alterlleo/kiba-board/kiba.kicad_pcb

## KiCad design kiba.kicad_pcb (2025-09-12)

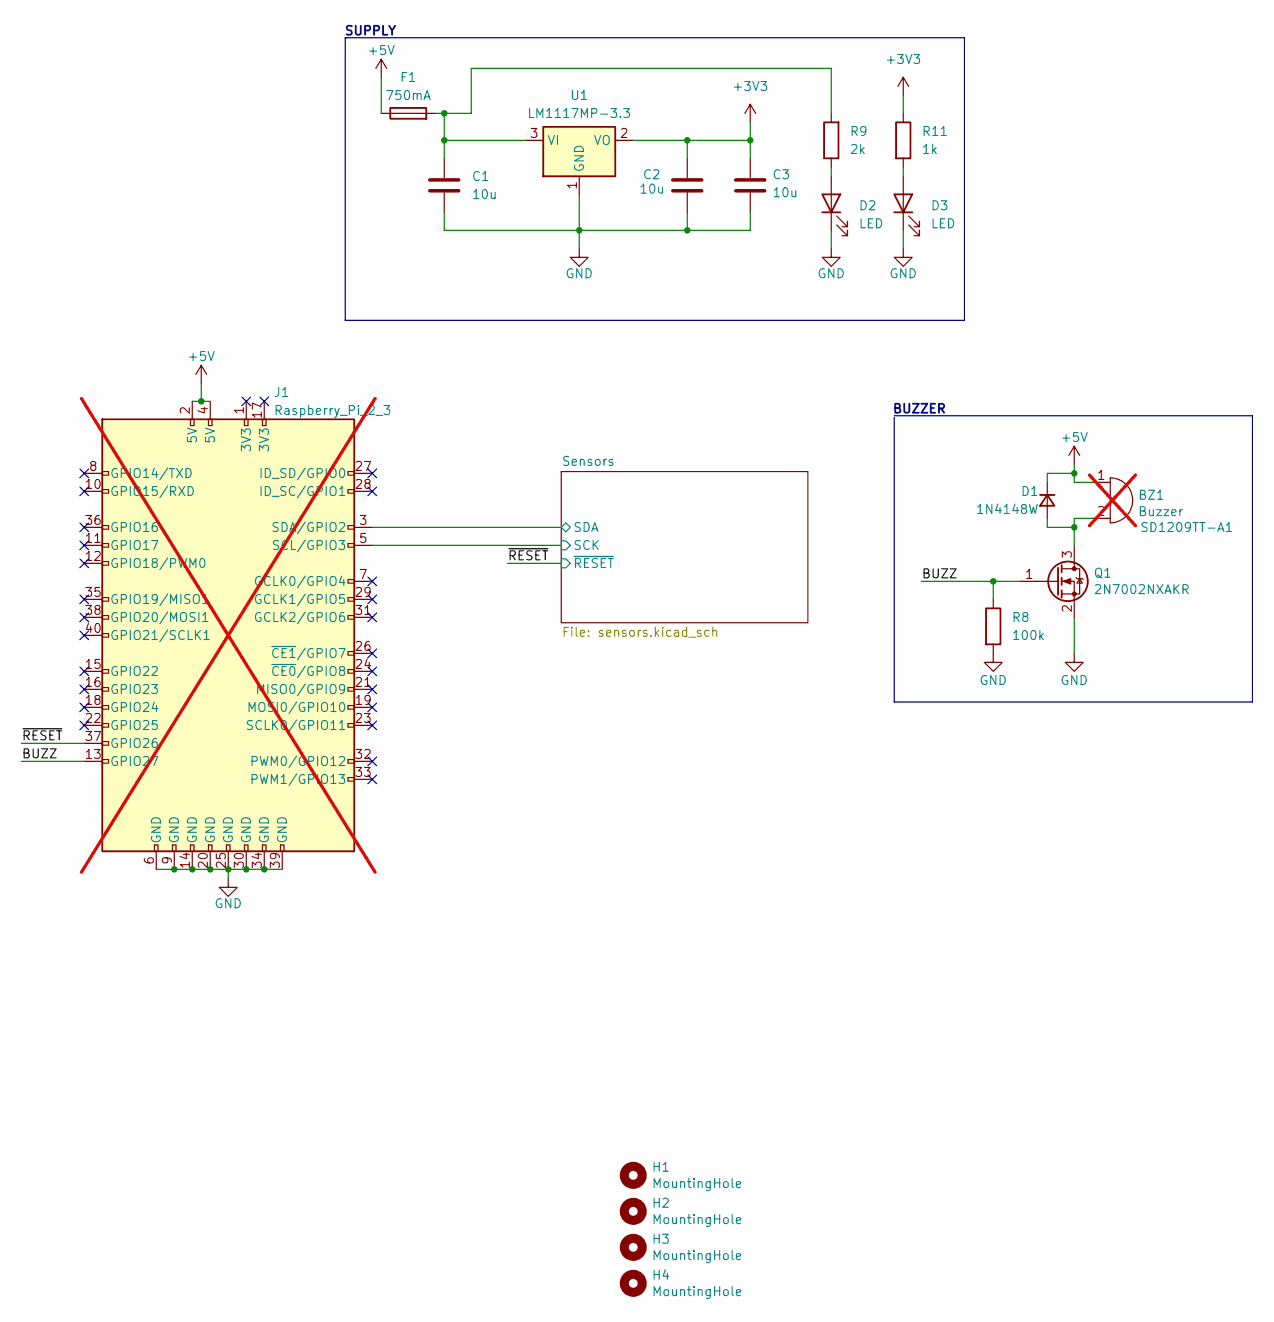
[picture p1: schematic kiba.kicad_sch]

Parts:
BZ1: Buzzer; Buzzer_TDK_PS1240P02BT_D12.2mm_H6.5mm; MPN SD1209TT-A1; LCSC C91083; not fitted
C1, C2, C3: 10u; C_0603_1608Metric
D1: 1N4148W; D_SOD-323_HandSoldering; MPN 1N4148W; LCSC C2099
D2: LED; D_0603_1608Metric; MPN TLMS1000-GS15; LCSC C2288
D3: LED; D_0603_1608Metric; MPN TLMS1000-GS15; LCSC C12624
F1: 750mA; Fuse_0603_1608Metric; LCSC C206991
H1, H2, H3, H4: MountingHole; MountingHole_3.2mm_M3_ISO14580
J1: Raspberry_Pi_2_3; raspberrypi; MPN 2.54-2*20; LCSC C2977589; not fitted
Q1: 2N7002NXAKR; SOT-23; MPN 2N7002NXAKR; LCSC C551416
R8: 100k; R_0603_1608Metric
R9: 2k; R_0603_1608Metric
R11: 1k; R_0603_1608Metric
U1: LM1117MP-3.3; SOT-223-3_TabPin2; MPN LM1117MP-3.3/TR; LCSC C498153

Connections:
+3V3: C2.1, C3.1, R11.1, U1.2 (VO); also elsewhere on the board
+5V: BZ1.1 (-), D1.1 (K), F1.1, J1.2 (5V), J1.4 (5V)
/BUZZ: J1.13 (GPIO27), Q1.1 (G), R8.1
/Sensors/SCK: J1.5 (SCL/GPIO3); also elsewhere on the board
/Sensors/SDA: J1.3 (SDA/GPIO2); also elsewhere on the board
/~RESET: J1.37 (GPIO26); also elsewhere on the board
GND: C1.2, C2.2, C3.2, D2.1 (K), D3.1 (K), J1.6 (GND), J1.9 (GND), J1.14 (GND), J1.20 (GND), J1.25 (GND), J1.30 (GND), J1.34 (GND), J1.39 (GND), Q1.2 (S), R8.2, U1.1 (GND); also elsewhere on the board
unnamed: BZ1.2 (+), D1.2 (A), Q1.3 (D)
unnamed: D2.2 (A), R9.1
unnamed: D3.2 (A), R11.2
unnamed: C1.1, F1.2, R9.2, U1.3 (VI)

Notes on the sheet:
SUPPLY
BUZZER

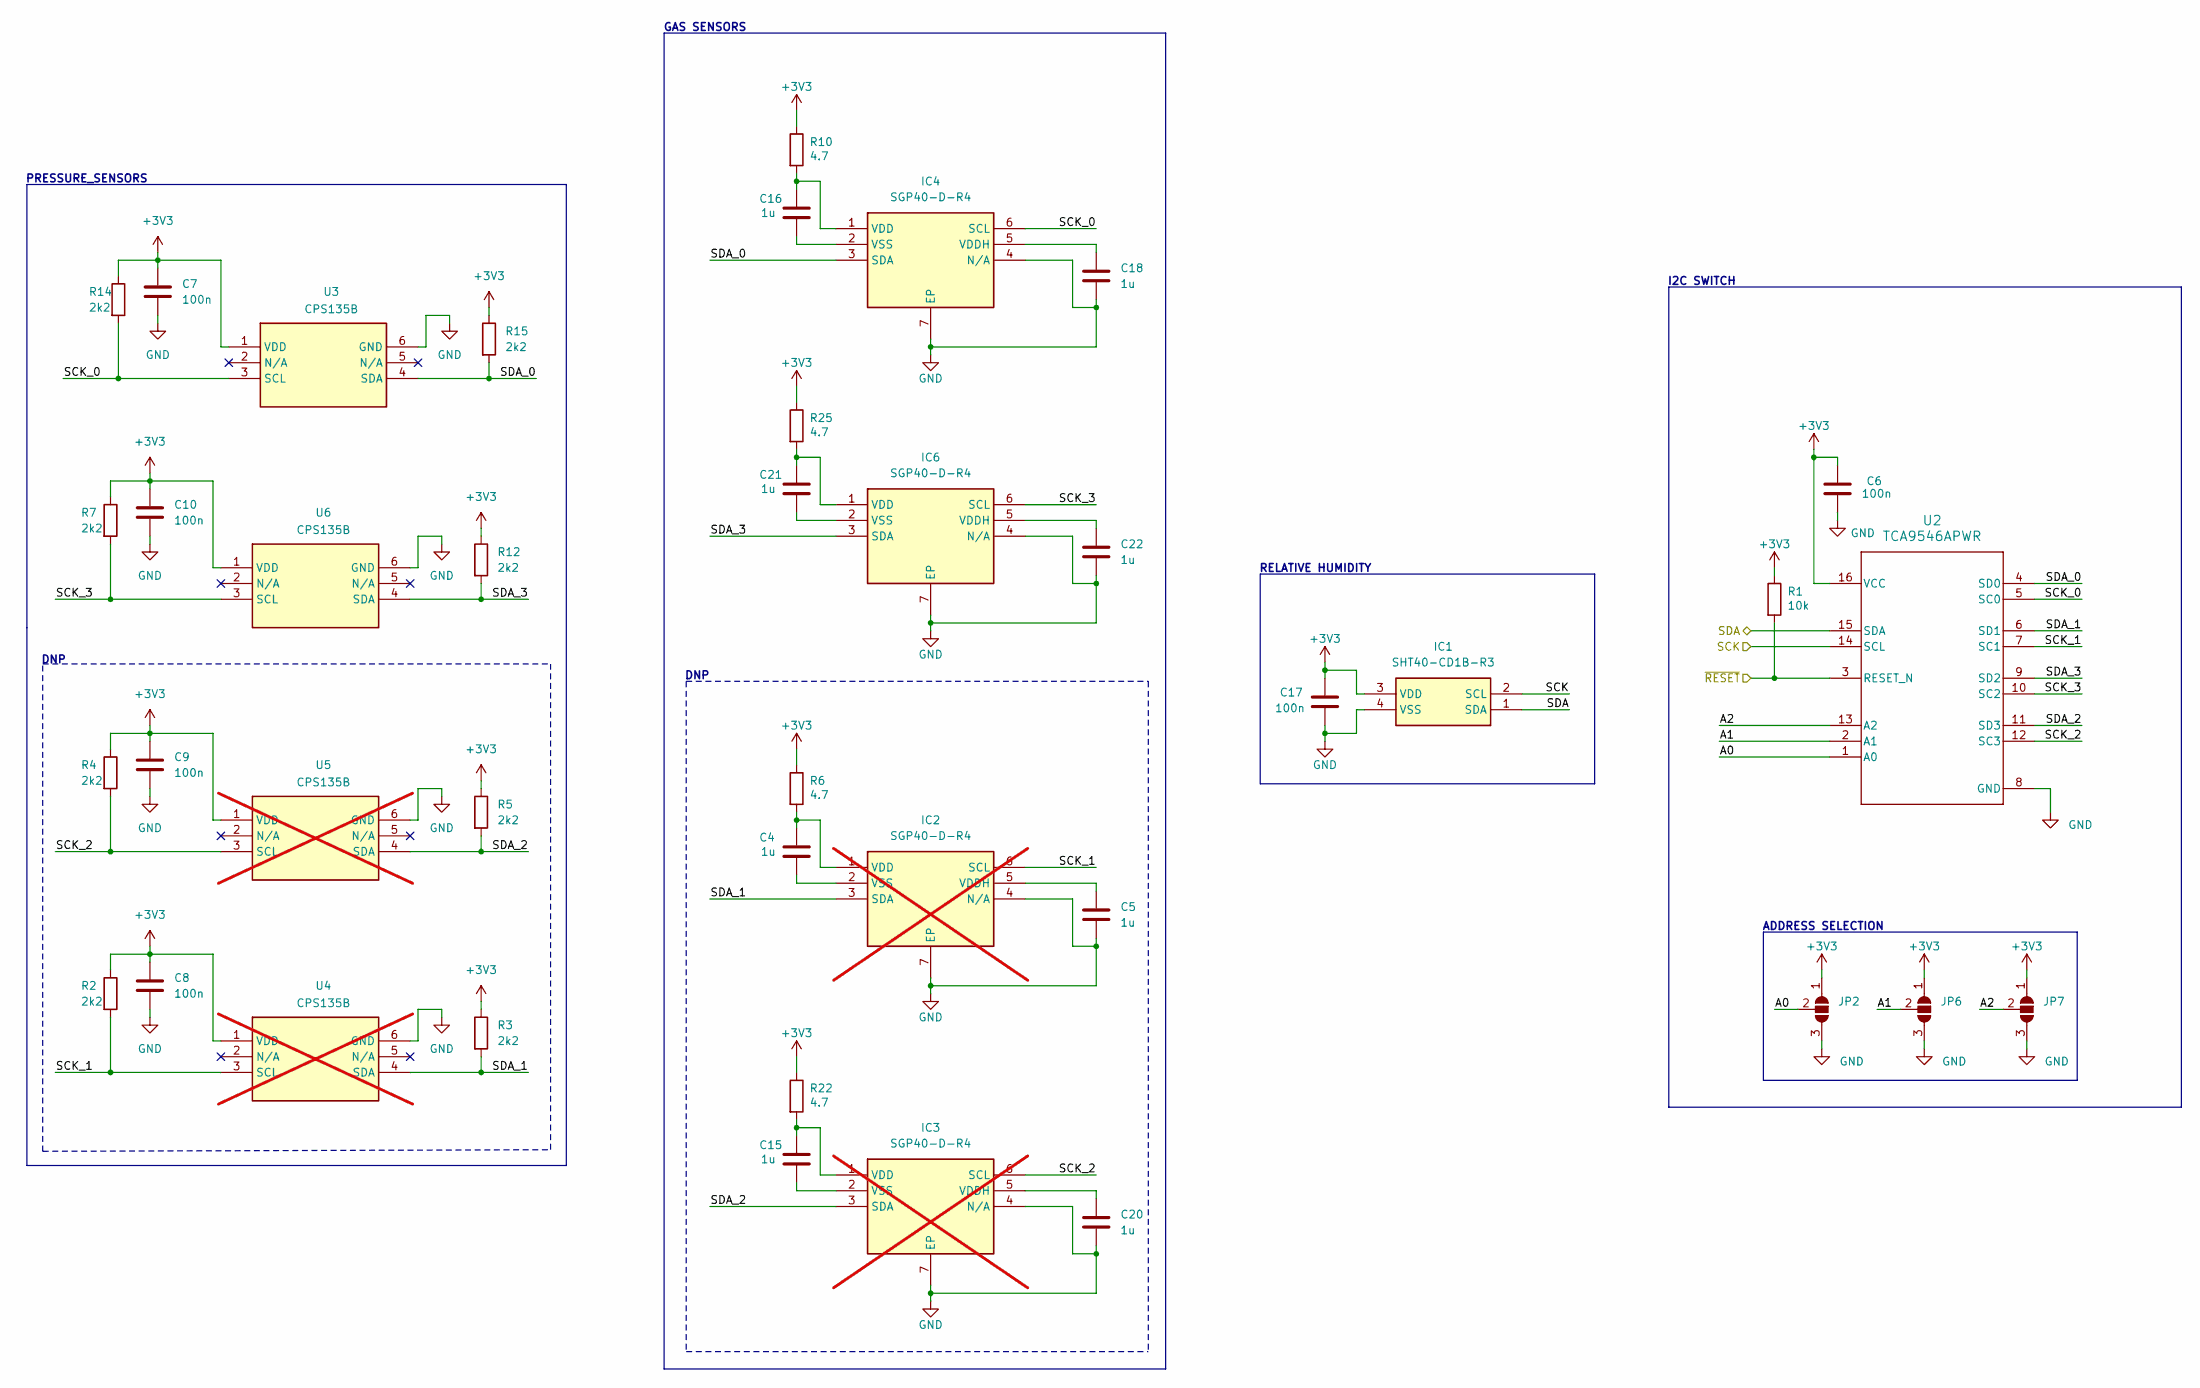
[picture p2: schematic sensors.kicad_sch]

Parts:
C4, C5, C15, C16, C18, C20, C21, C22: 1u; C_0603_1608Metric
C6, C7, C8, C9, C10, C17: 100n; C_0603_1608Metric
IC1: SHT40-CD1B-R3; SHT40CD1BR3; Mouser Part Number 403-SHT40-CD1B-R3
IC2, IC3: SGP40-D-R4; SON80P244X244X95-7N; Mouser Part Number 403-SGP40-D-R4; not fitted
IC4, IC6: SGP40-D-R4; SON80P244X244X95-7N; Mouser Part Number 403-SGP40-D-R4
JP2, JP6, JP7: SolderJumper_3_Open; SolderJumper-3_P1.3mm_Open_RoundedPad1.0x1.5mm
R1: 10k; R_0603_1608Metric
R2, R3, R4, R5, R7, R12, R14, R15: 2k2; R_0603_1608Metric
R6, R10, R22, R25: 4.7; R_0603_1608Metric
U2: TCA9546APWR; PW0016A-IPC_A; LCSC C201653
U3, U6: CPS135B; smd6-4.5mm; LCSC C491452
U4, U5: CPS135B; smd6-4.5mm; LCSC C491452; not fitted

Connections:
+3V3: C6.1, C7.1, C8.1, C9.1, C10.1, C17.1, IC1.3 (VDD), JP2.1 (A), JP6.1 (A), JP7.1 (A), R1.1, R2.1, R3.1, R4.1, R5.1, R6.1, R7.1, R10.1, R12.1, R14.1, R15.1, R22.1, R25.1, U2.16 (VCC), U3.1 (VDD), U4.1 (VDD), U5.1 (VDD), U6.1 (VDD); also elsewhere on the board
/Sensors/A0: JP2.2 (C), U2.1 (A0)
/Sensors/A1: JP6.2 (C), U2.2 (A1)
/Sensors/A2: JP7.2 (C), U2.13 (A2)
/Sensors/SCK: IC1.2 (SCL), U2.14 (SCL); also elsewhere on the board
/Sensors/SCK_0: IC4.6 (SCL), R14.2, U2.5 (SC0), U3.3 (SCL)
/Sensors/SCK_1: IC2.6 (SCL), R2.2, U2.7 (SC1), U4.3 (SCL)
/Sensors/SCK_2: IC3.6 (SCL), R4.2, U2.12 (SC3), U5.3 (SCL)
/Sensors/SCK_3: IC6.6 (SCL), R7.2, U2.10 (SC2), U6.3 (SCL)
/Sensors/SDA: IC1.1 (SDA), U2.15 (SDA); also elsewhere on the board
/Sensors/SDA_0: IC4.3 (SDA), R15.2, U2.4 (SD0), U3.4 (SDA)
/Sensors/SDA_1: IC2.3 (SDA), R3.2, U2.6 (SD1), U4.4 (SDA)
/Sensors/SDA_2: IC3.3 (SDA), R5.2, U2.11 (SD3), U5.4 (SDA)
/Sensors/SDA_3: IC6.3 (SDA), R12.2, U2.9 (SD2), U6.4 (SDA)
/~RESET: R1.2, U2.3 (RESET_N); also elsewhere on the board
GND: C5.2, C6.2, C7.2, C8.2, C9.2, C10.2, C17.2, C18.2, C20.2, C22.2, IC1.4 (VSS), IC2.4 (N/A), IC2.7 (EP), IC3.4 (N/A), IC3.7 (EP), IC4.4 (N/A), IC4.7 (EP), IC6.4 (N/A), IC6.7 (EP), JP2.3 (B), JP6.3 (B), JP7.3 (B), U2.8 (GND), U3.6 (GND), U4.6 (GND), U5.6 (GND), U6.6 (GND); also elsewhere on the board
unnamed: C4.1, IC2.1 (VDD), R6.2
unnamed: C5.1, IC2.5 (VDDH)
unnamed: C4.2, IC2.2 (VSS)
unnamed: C15.1, IC3.1 (VDD), R22.2
unnamed: C20.1, IC3.5 (VDDH)
unnamed: C15.2, IC3.2 (VSS)
unnamed: C16.1, IC4.1 (VDD), R10.2
unnamed: C18.1, IC4.5 (VDDH)
unnamed: C16.2, IC4.2 (VSS)
unnamed: C21.1, IC6.1 (VDD), R25.2
unnamed: C22.1, IC6.5 (VDDH)
unnamed: C21.2, IC6.2 (VSS)

Notes on the sheet:
GAS SENSORS
I2C SWITCH
DNP
ADDRESS SELECTION
RELATIVE HUMIDITY
PRESSURE_SENSORS

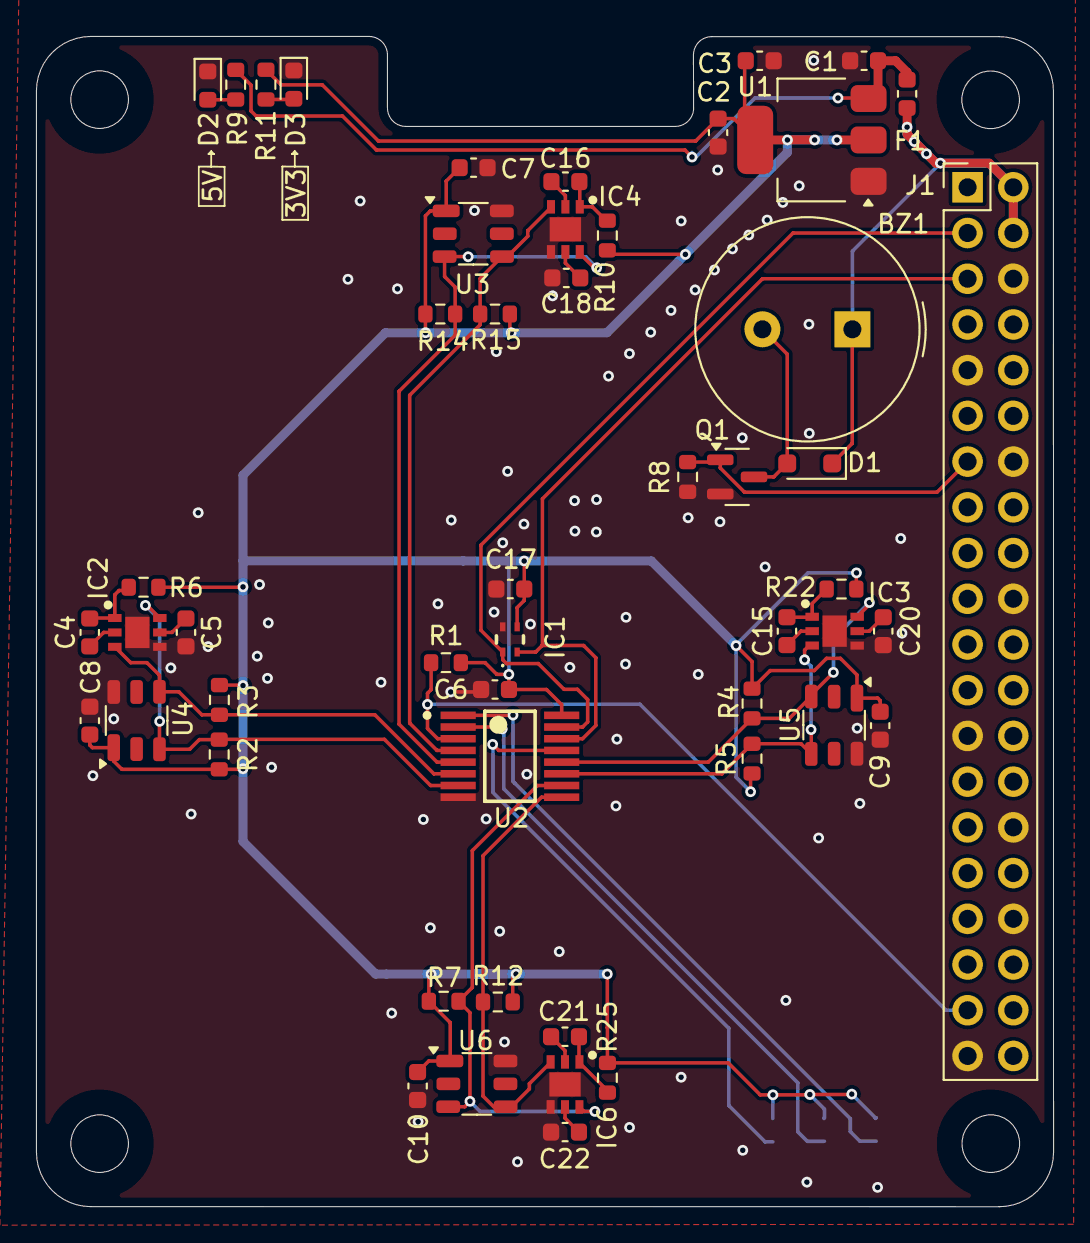
[picture p3: board kiba.kicad_pcb from above]

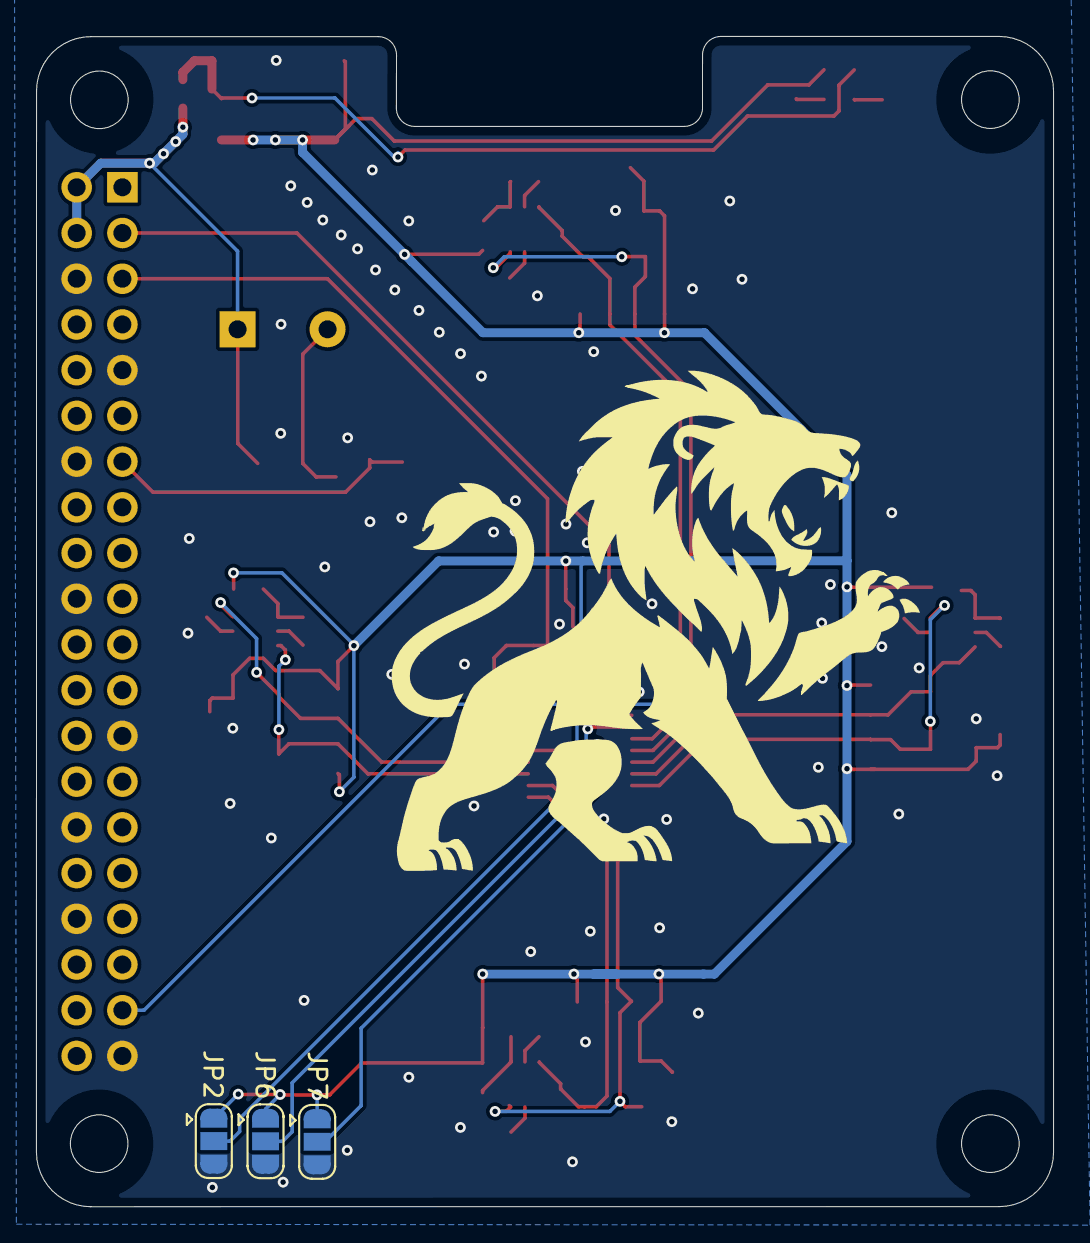
[picture p4: board kiba.kicad_pcb from below]

Board: 2 copper layers, 56.5 x 65.0 mm, 58 parts (3 on the bottom side), 34 nets.
