alterlleo/kiba-board/(commit log)

2025-08-29 feat: add sensors libraries
    [pressure-sense.kicad_sch, voc-sense.kicad_sch]
2025-08-29 feat: initial setup
    [kiba.kicad_pcb, kiba.kicad_sch]
2025-08-29 fix: bmp581 config
    [kiba.kicad_sch, pressure-sense.kicad_sch]
2025-08-30 feat: add buzzer
    [kiba.kicad_sch]
2025-08-30 feat: new configuration with i2c switch
    [kiba.kicad_sch, sensors.kicad_sch]
2025-08-30 fix: cleanup
    [pressure-sense.kicad_sch, voc-sense.kicad_sch]
2025-08-31 fix: arrange board for a total of 8 sensors, 4 DNP
    [sensors.kicad_sch]
2025-08-31 feat: address selection i2c switch
    [kiba.kicad_sch, sensors.kicad_sch]
2025-08-31 feat: rasp connections + fan
    [kiba.kicad_sch, sensors.kicad_sch]
2025-08-31 fix: missing footprints
    [kiba.kicad_sch, sensors.kicad_sch]
2025-09-02 fix: missing save and add leds + fuse on power supply
    [kiba.kicad_sch]
2025-09-02 fix: fllags and footprints
    [kiba.kicad_sch, sensors.kicad_sch]
2025-09-02 feat: pcb first draft
    [kiba.kicad_pcb]
2025-09-02 feat: first sensors couple connected
    [sensors.kicad_sch]
2025-09-02 feat: first pcb draft completed
    [kiba.kicad_pcb, sensors.kicad_sch]
2025-09-02 fix: drc errors
    [kiba.kicad_pcb, kiba.kicad_sch]
2025-09-02 fix: silkscreen
    [kiba.kicad_pcb]
2025-09-03 fix: missing 3d models
    [kiba.kicad_pcb]
2025-09-03 fix: 4 channels i2c switch
    [kiba.kicad_pcb, sensors.kicad_sch]
2025-09-03 feat: add RH sensor
    [kiba.kicad_pcb, sensors.kicad_sch]
2025-09-04 fix: gnd zones clearane decreased
    [kiba.kicad_pcb]
2025-09-04 fix: minors
    [kiba.kicad_pcb]
2025-09-06 fix: unused i2c pullups
    [sensors.kicad_sch]
2025-09-06 fix: i2c layout with vias
    [kiba.kicad_pcb]
2025-09-06 fix: dnp in opposite edges
    [kiba.kicad_pcb, sensors.kicad_sch]
2025-09-07 feat: pullup resistors values
    [sensors.kicad_sch]
2025-09-07 fix: pullup resistors layout
    [kiba.kicad_pcb]
2025-09-07 prod: add MPN
    [kiba.kicad_sch]
2025-09-08 Added JLCPCB part numbers and generated BOM
    [BOM-kiba.csv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]
2025-09-08 fix: cps135b as new barometer
    [kiba.kicad_pcb, sensors.kicad_sch]
2025-09-12 production files for jlcpcb, added passives for DNP sensors
    [BOM-kiba.csv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]
